Fihdi/DSP-FX32/DSPFX-Schematic.pdf

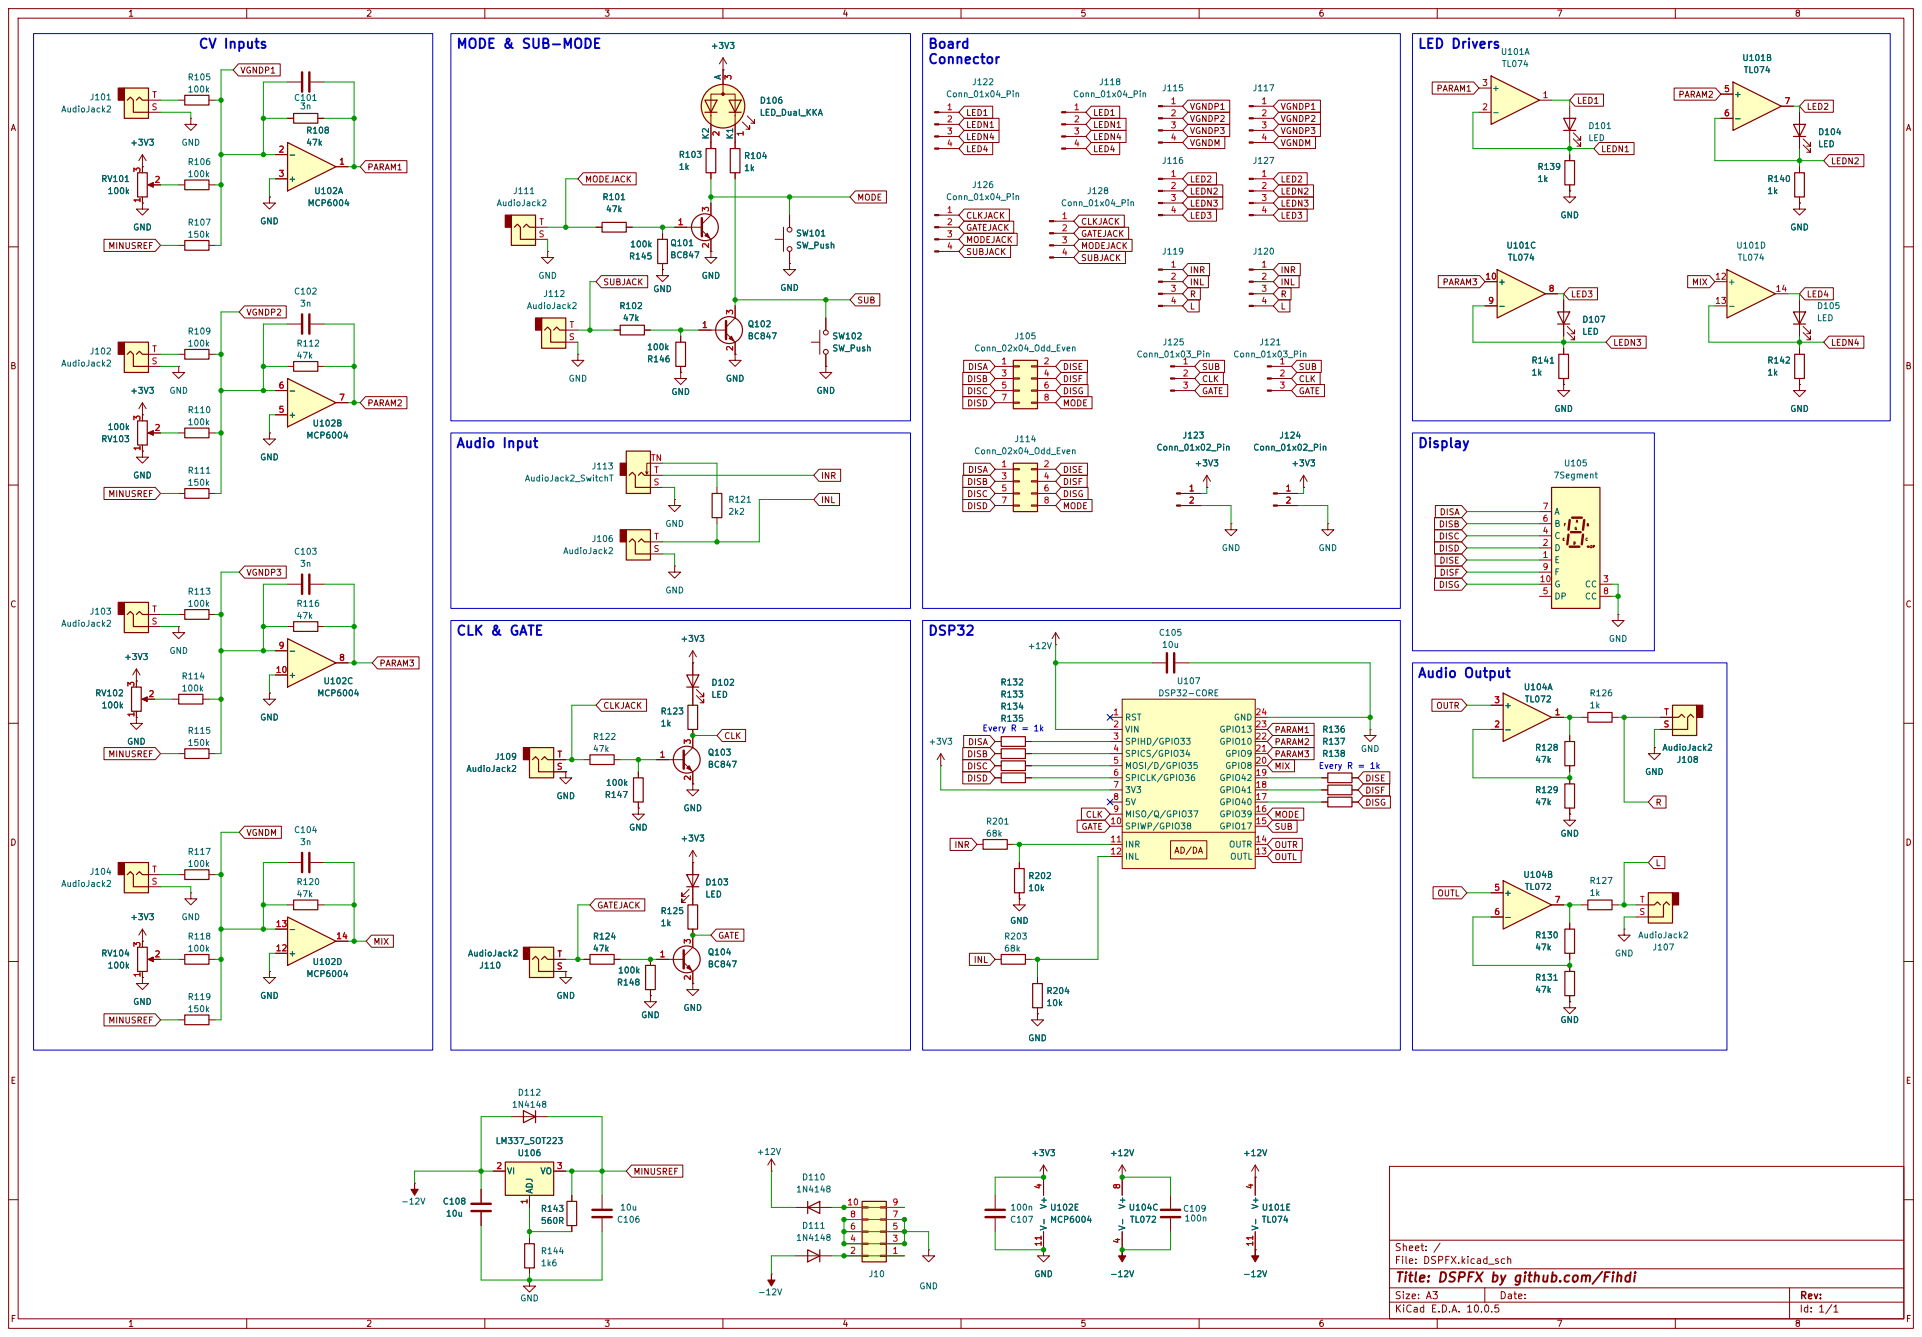
[picture p2: page 1]

Sheet: /
File: DSPFX.kicad_sch
Title: DSPFX by github.com/Fihdi

Size: A3 | Rev: | F Date:
KiCad E.D.A. 10.0.5 | Id: 1/1
