Fihdi/DSP-FX32/DSPFX.kicad_pcb

## KiCad design DSPFX.kicad_pcb (2026-08-17)

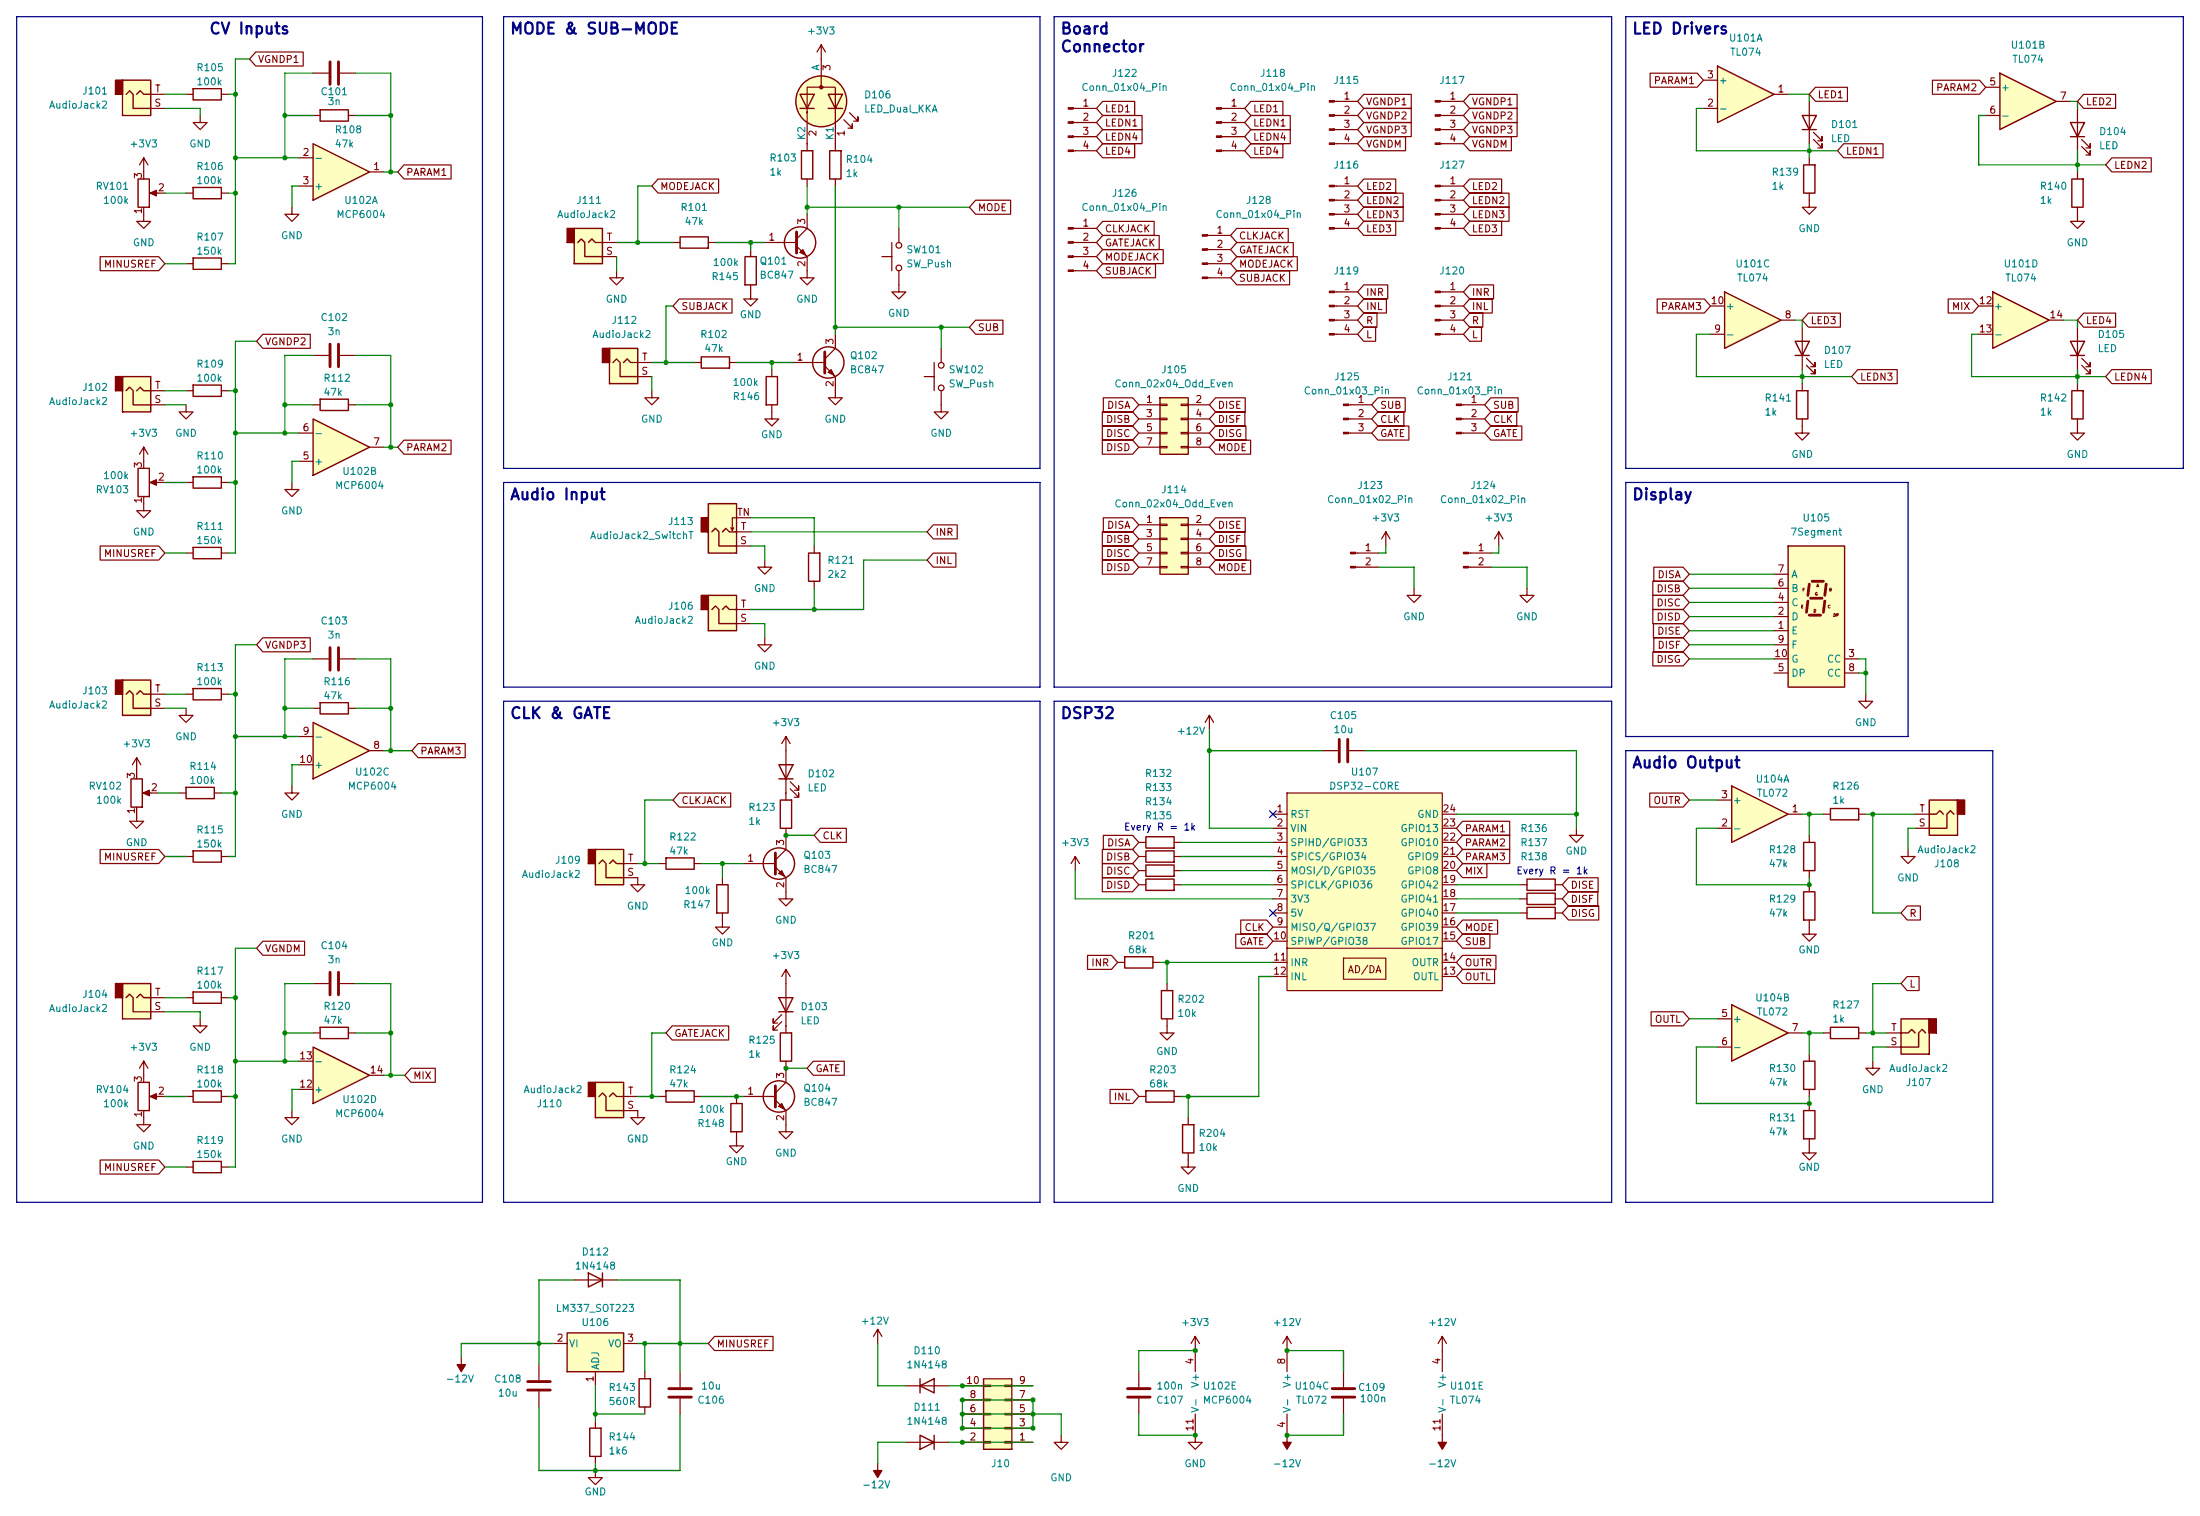
[picture p3: schematic DSPFX.kicad_sch, DSPFX by github.com/Fihdi]

Parts:
C101, C102, C103, C104: 3n; C_1206_3216Metric
C105, C106, C108: 10u; C_1206_3216Metric
C107, C109: 100n; C_1206_3216Metric
D101, D102, D103, D104, D105, D107: LED; LED_D3.0mm
D106: LED_Dual_KKA; LED_D5.0mm-3
D110, D111, D112: 1N4148; D_SOD-323_HandSoldering
J10: Conn_02x05_Odd_Even; IDC-Header_2x05_P2.54mm_Vertical
J101, J102, J103, J104, J106, J107, J108, J109, J110, J111, J112: AudioJack2; MonoTRS
J105, J114: Conn_02x04_Odd_Even; PinSocket_2x04_P2.54mm_Vertical
J113: AudioJack2_SwitchT; MonoTRS
J115, J116, J117, J119, J120, J127: Conn_01x04_Pin; PinSocket_1x04_P2.54mm_Vertical
J118, J122, J126, J128: Conn_01x04_Pin; PinHeader_1x04_P2.54mm_Vertical
J121, J125: Conn_01x03_Pin; PinSocket_1x03_P2.54mm_Vertical
J123, J124: Conn_01x02_Pin; PinHeader_1x02_P2.54mm_Vertical
Q101, Q102, Q103, Q104: BC847; SOT-23
R101, R102, R108, R112, R116, R120, R122, R124, R128, R129, R130, R131: 47k; R_1206_3216Metric
R103, R104, R123, R125, R126, R127, R132, R133, R134, R135, R136, R137, R138, R139, R140, R141, R142: 1k; R_1206_3216Metric
R105, R106, R109, R110, R113, R114, R117, R118, R145, R146, R147, R148: 100k; R_1206_3216Metric
R107, R111, R115, R119: 150k; R_1206_3216Metric
R121: 2k2; R_1206_3216Metric
R143: 560R; R_1206_3216Metric
R144: 1k6; R_1206_3216Metric
R201, R203: 68k; R_1206_3216Metric
R202, R204: 10k; R_1206_3216Metric
RV101, RV102, RV103, RV104: 100k; Potentiometer_Alpha_RD901F-40-00D_Single_Vertical
SW101, SW102: SW_Push; PushButton
U101: TL074; SOIC-14_3.9x8.7mm_P1.27mm
U102: MCP6004; SOIC-14_3.9x8.7mm_P1.27mm
U104: TL072; SOIC-8_3.9x4.9mm_P1.27mm
U105: 7Segment; 7SegmentLED_LTS6760_LTS6780
U106: LM337_SOT223; SOT-223-3_TabPin2
U107: DSP32-CORE; ESP32-SEED

Connections:
+3V3: C107.1, D102.2 (A), D103.2 (A), D106.3 (A), J123.1, J124.1, RV101.3, RV102.3, RV103.3, RV104.3, U102.4 (V+), U107.7 (3V3)
+12V: C105.2, C109.2, D110.1 (K), U101.4 (V+), U104.8 (V+), U107.2 (VIN)
-12V: C108.2, C109.1, D111.2 (A), D112.2 (A), U101.11 (V-), U104.4 (V-), U106.2 (VI)
CLK: J121.2, J125.2, Q103.3 (C), R123.1, U107.9 (MISO/Q/GPIO37)
CLKJACK: J109.T, J126.1, J128.1, R122.2
DISA: J105.1, J114.1, R132.1, U105.7 (A)
DISB: J105.3, J114.3, R133.1, U105.6 (B)
DISC: J105.5, J114.5, R134.1, U105.4 (C)
DISD: J105.7, J114.7, R135.1, U105.2 (D)
DISE: J105.2, J114.2, R136.2, U105.1 (E)
DISF: J105.4, J114.4, R137.2, U105.9 (F)
DISG: J105.6, J114.6, R138.2, U105.10 (G)
GATE: J121.3, J125.3, Q104.3 (C), R125.1, U107.10 (SPIWP/GPIO38)
GATEJACK: J110.T, J126.2, J128.2, R124.2
GND: C105.1, C106.2, C107.2, C108.1, J10.3, J10.4, J10.5, J10.6, J10.7, J10.8, J101.S, J102.S, J103.S, J104.S, J106.S, J107.S, J108.S, J109.S, J110.S, J111.S, J112.S, J113.S, J123.2, J124.2, Q101.2 (E), Q102.2 (E), Q103.2 (E), Q104.2 (E), R129.2, R131.2, R139.1, R140.1, R141.1, R142.1, R144.1, R145.2, R146.2, R147.2, R148.2, R202.1, R204.1, RV101.1, RV102.1, RV103.1, RV104.1, SW101.1, SW102.1, U102.3 (+), U102.5 (+), U102.10 (+), U102.11 (V-), U102.12 (+), U105.3 (CC), U105.8 (CC), U107.24 (GND)
INL: J106.T, J119.2, J120.2, R121.1, R203.2
INR: J113.T, J119.1, J120.1, R201.2
L: J107.T, J119.4, J120.4, R127.2
LED1: D101.2 (A), J118.1, J122.1, U101.1
LED2: D104.2 (A), J116.1, J127.1, U101.7
LED3: D107.2 (A), J116.4, J127.4, U101.8
LED4: D105.2 (A), J118.4, J122.4, U101.14
LEDN1: D101.1 (K), J118.2, J122.2, R139.2, U101.2 (-)
LEDN2: D104.1 (K), J116.2, J127.2, R140.2, U101.6 (-)
LEDN3: D107.1 (K), J116.3, J127.3, R141.2, U101.9 (-)
LEDN4: D105.1 (K), J118.3, J122.3, R142.2, U101.13 (-)
MINUSREF: C106.1, D112.1 (K), R107.2, R111.2, R115.2, R119.2, R143.2, U106.3 (VO)
MIX: C104.1, R120.1, U101.12 (+), U102.14, U107.20 (GPIO8)
MODE: J105.8, J114.8, Q101.3 (C), R103.1, SW101.2, U107.16 (GPIO39)
MODEJACK: J111.T, J126.3, J128.3, R101.1
unnamed: D102.1 (K), R123.2
unnamed: D103.1 (K), R125.2
unnamed: D106.1 (K1), R104.2
unnamed: D106.2 (K2), R103.2
unnamed: D110.2 (A), J10.9, J10.10
unnamed: D111.1 (K), J10.1, J10.2
unnamed: J101.T, R105.2
unnamed: J102.T, R109.2
unnamed: J103.T, R113.2
unnamed: J104.T, R117.2
unnamed: J113.TN, R121.2
unnamed: Q101.1 (B), R101.2, R145.1
unnamed: Q102.1 (B), R102.2, R146.1
unnamed: Q103.1 (B), R122.1, R147.1
unnamed: Q104.1 (B), R124.1, R148.1
unnamed: R106.2, RV101.2
unnamed: R110.2, RV103.2
unnamed: R114.2, RV102.2
unnamed: R118.2, RV104.2
unnamed: R126.1, R128.1, U104.1
unnamed: R127.1, R130.1, U104.7
unnamed: R128.2, R129.1, U104.2 (-)
unnamed: R130.2, R131.1, U104.6 (-)
unnamed: R143.1, R144.2, U106.1 (ADJ)
unnamed: R138.1, U107.17 (GPIO40)
unnamed: R137.1, U107.18 (GPIO41)
unnamed: R136.1, U107.19 (GPIO42)
unnamed: R203.1, R204.2, U107.12 (INL)
unnamed: R201.1, R202.2, U107.11 (INR)
unnamed: R134.2, U107.5 (MOSI/D/GPIO35)
unnamed: R135.2, U107.6 (SPICLK/GPIO36)
unnamed: R133.2, U107.4 (SPICS/GPIO34)
unnamed: R132.2, U107.3 (SPIHD/GPIO33)
OUTL: U104.5 (+), U107.13 (OUTL)
OUTR: U104.3 (+), U107.14 (OUTR)
PARAM1: C101.1, R108.1, U101.3 (+), U102.1, U107.23 (GPIO13)
PARAM2: C102.1, R112.1, U101.5 (+), U102.7, U107.22 (GPIO10)
PARAM3: C103.1, R116.1, U101.10 (+), U102.8, U107.21 (GPIO9)
R: J108.T, J119.3, J120.3, R126.2
SUB: J121.1, J125.1, Q102.3 (C), R104.1, SW102.2, U107.15 (GPIO17)
SUBJACK: J112.T, J126.4, J128.4, R102.1
VGNDM: C104.2, J115.4, J117.4, R117.1, R118.1, R119.1, R120.2, U102.13 (-)
VGNDP1: C101.2, J115.1, J117.1, R105.1, R106.1, R107.1, R108.2, U102.2 (-)
VGNDP2: C102.2, J115.2, J117.2, R109.1, R110.1, R111.1, R112.2, U102.6 (-)
VGNDP3: C103.2, J115.3, J117.3, R113.1, R114.1, R115.1, R116.2, U102.9 (-)

Notes on the sheet:
Every R = 1k
MODE & SUB-MODE
Audio Output
CLK & GATE
DSP32
Display
Audio Input
Board Connector
CV Inputs
LED Drivers

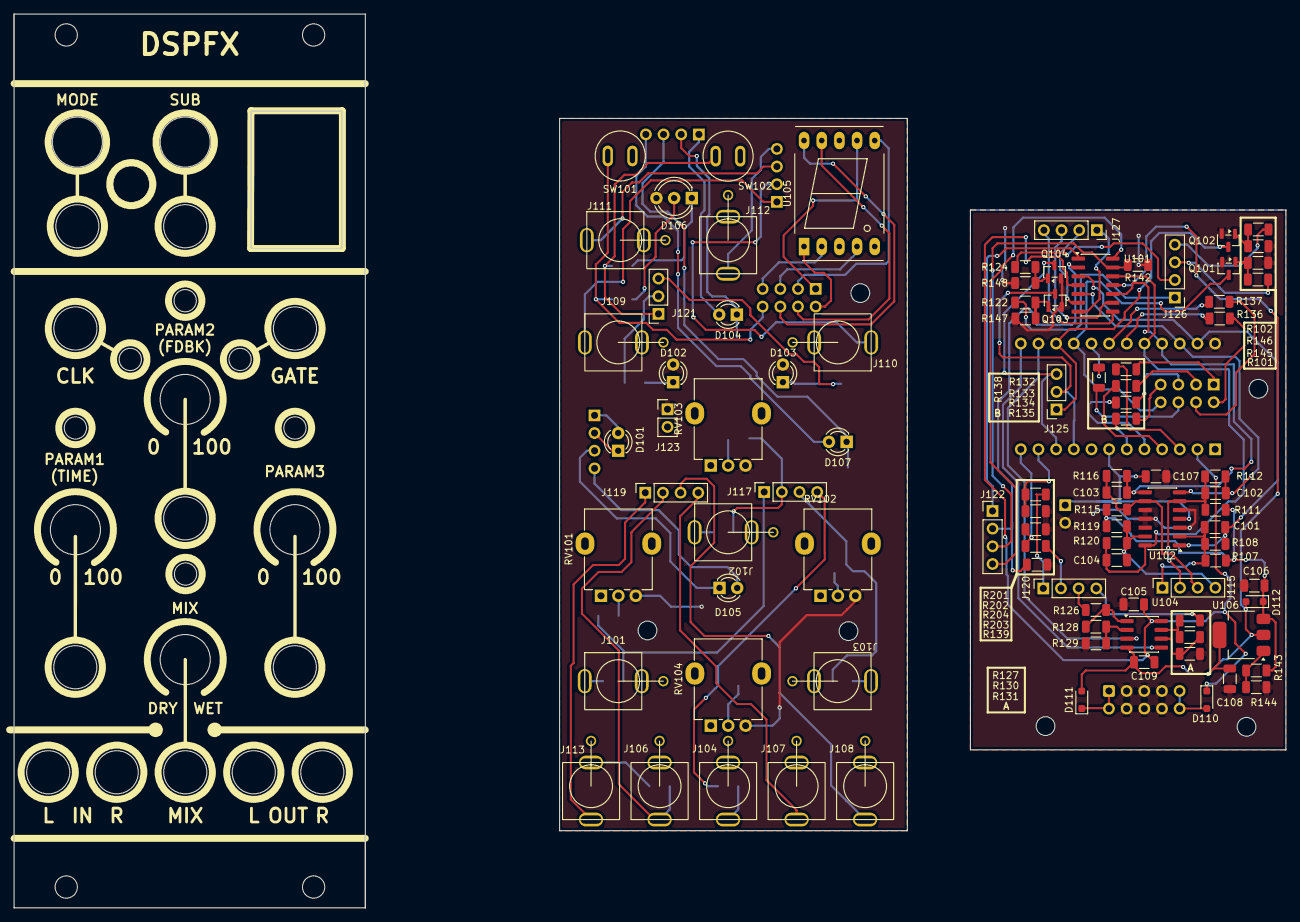
[picture p4: board DSPFX.kicad_pcb from above]

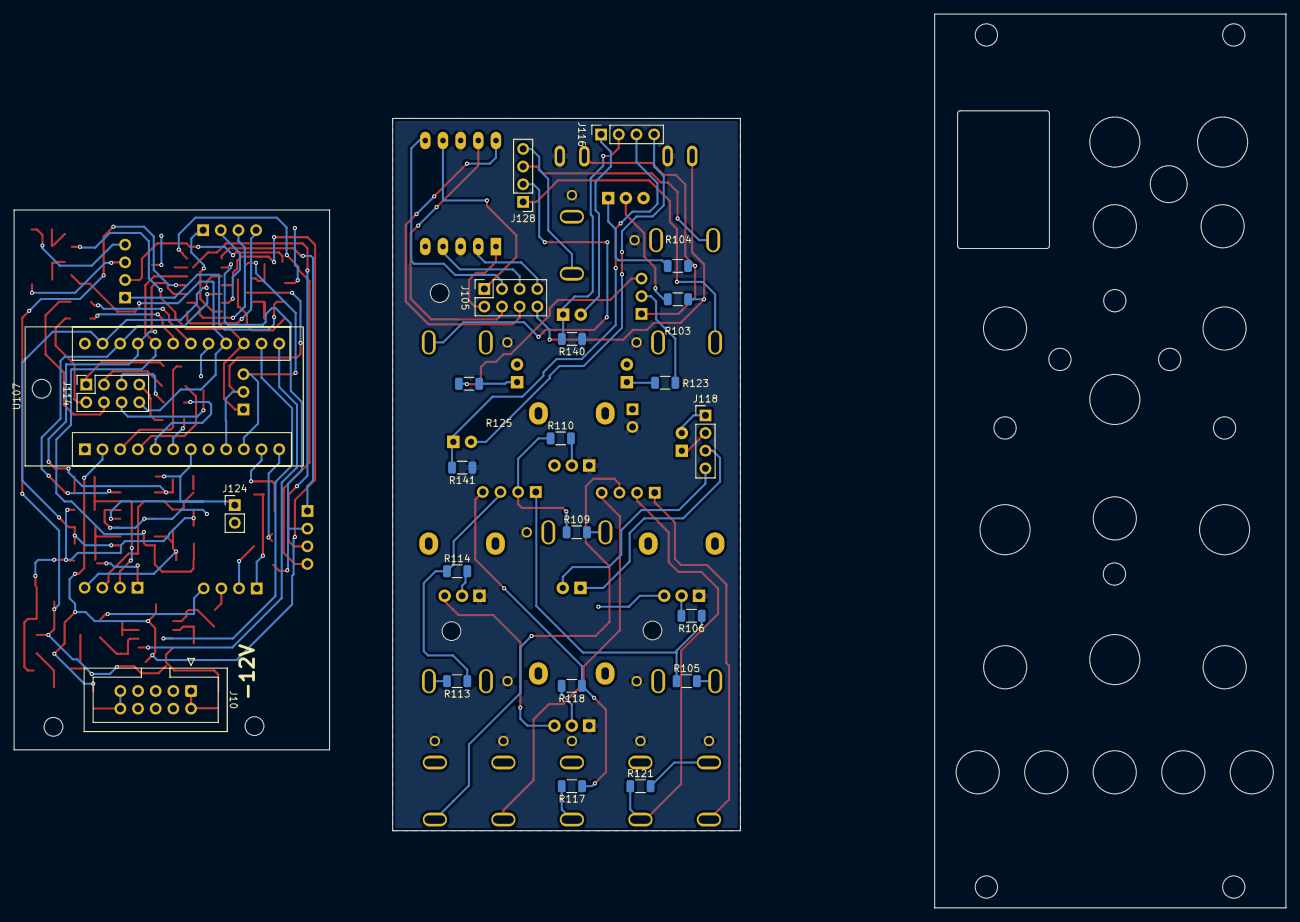
[picture p5: board DSPFX.kicad_pcb from below]

Board: 2 copper layers, 182.8 x 128.5 mm, 116 parts (23 on the bottom side), 75 nets.
