Fihdi/DSP-FX32/(commit log)

2026-08-17 Swapped LEDs and Potentiometer parity issue
    [DSPFX.kicad_pcb, DSPFX.kicad_sch]
2026-08-17 Delete DSP32FX-A.zip
    LED Parity issue
